csauer42/rover/avr/notes.txt

AVR Motor Control

Receives 11-byte control message for motor positions:

[FF]    [XX]   [XX]   [XX]   [XX]   [XX]   [XX]  [XX]  [XX]   [XX]   [XX] 
start   motor  motor  motor  motor  servo pan    servo tilt   <--crc_16-->
byte    left   right  left   right
        fw     fw     bw     bw

Responds with 10-bit ADC value in 2-byte message.

Fuse Settings:
0xE2 0xD9 0xFF

From default, uncheck 'Divide clock by 8 internally.'

Written for Atmel ATMega328P using Atmel Studio 7.  Pin selection
matches MotorControl schematic.
