csauer42/rover/schematics/rover-board.png

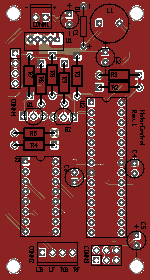
schematics/rover-board.png
