csauer42/rover/schematics/rover-pcb.pdf

# /home/csauer/Projects/rover/schematics/rover.pcb

# 1. Table of Contents (This Page) Created on Thu May 18 17:42:11 2017

# 2. top 3. bottom 4. outline 5. plated-drill 6. componentmask 7. soldermask 8. topsilk 9. bottomsilk 10. topassembly 11. bottomassembly 12. fab

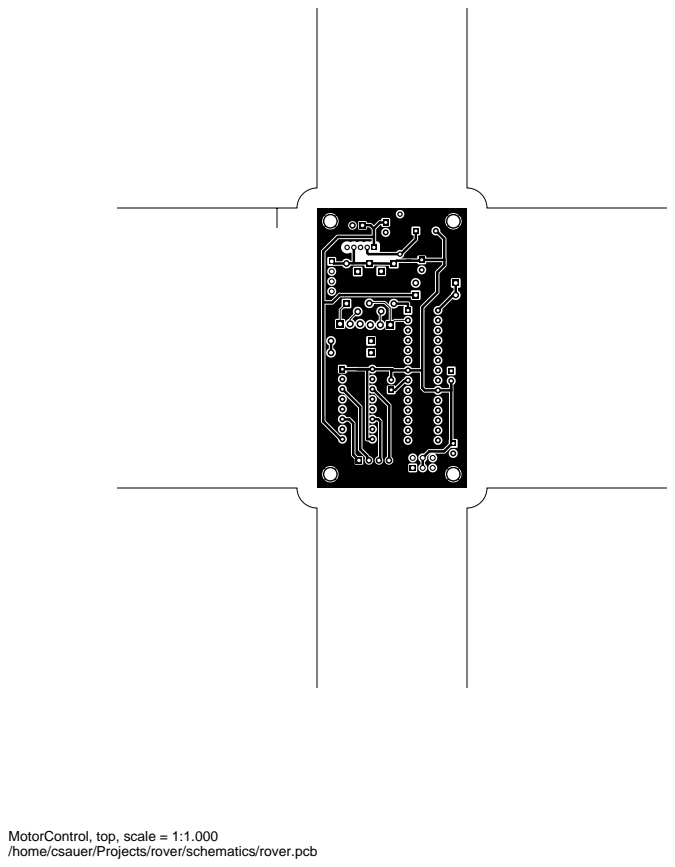
[picture p2: page 2]

MotorControl, top, scale = 1:1.000

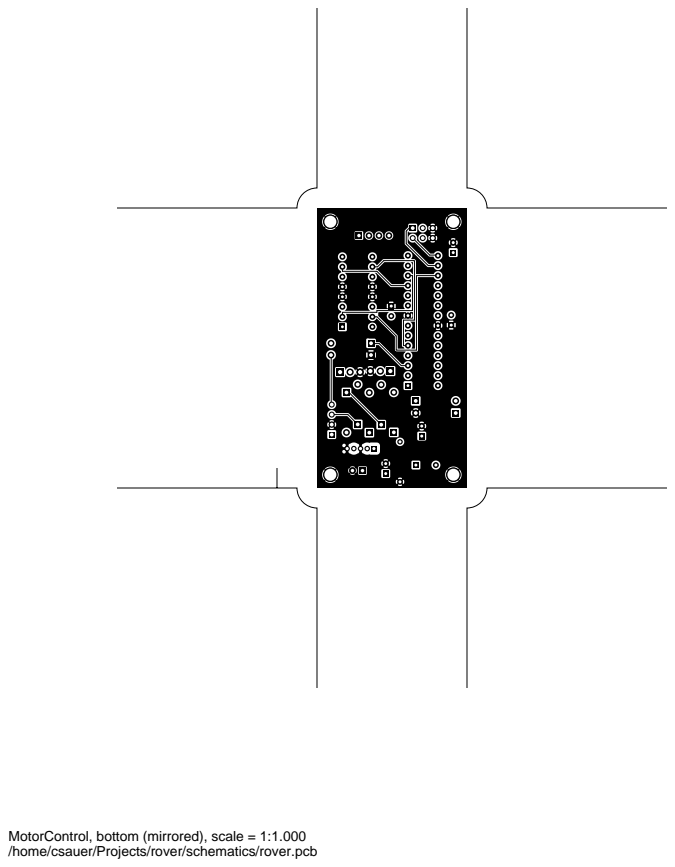
[picture p3: page 3]

MotorControl, bottom (mirrored), scale = 1:1.000

MotorControl, outline, scale = 1:1.000

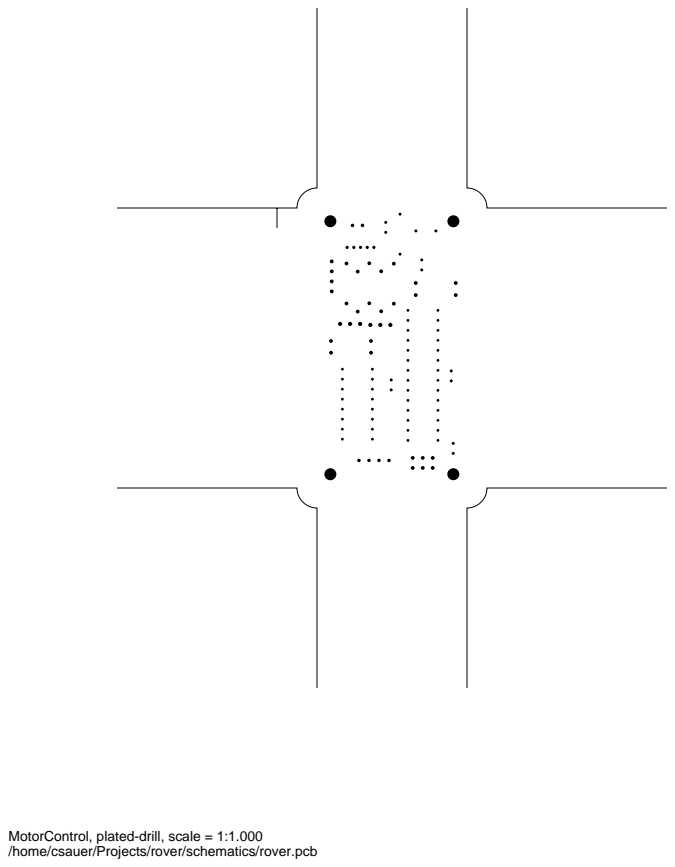
[picture p4: page 5]

MotorControl, plated-drill, scale = 1:1.000

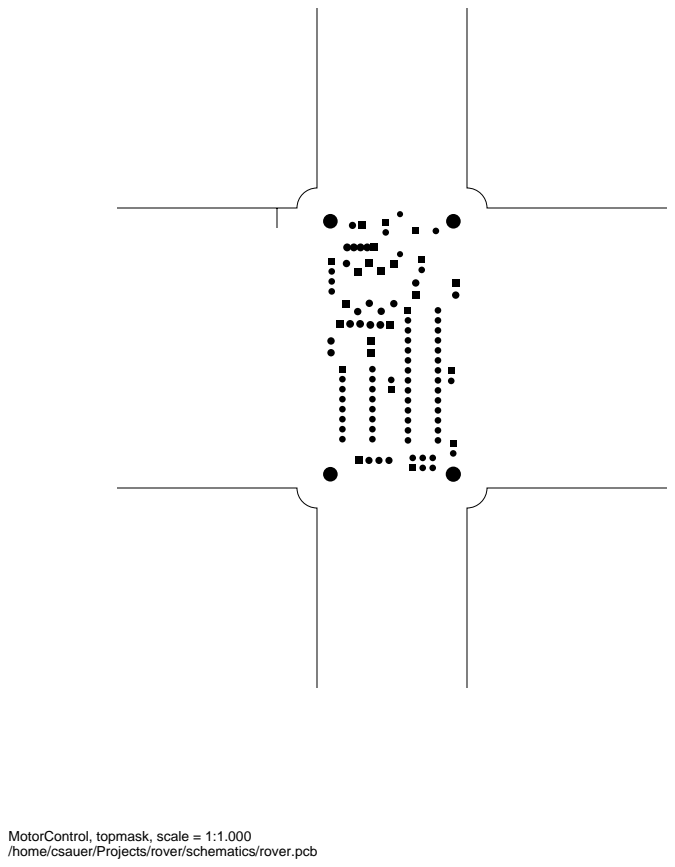
[picture p5: page 6]

MotorControl, topmask, scale = 1:1.000

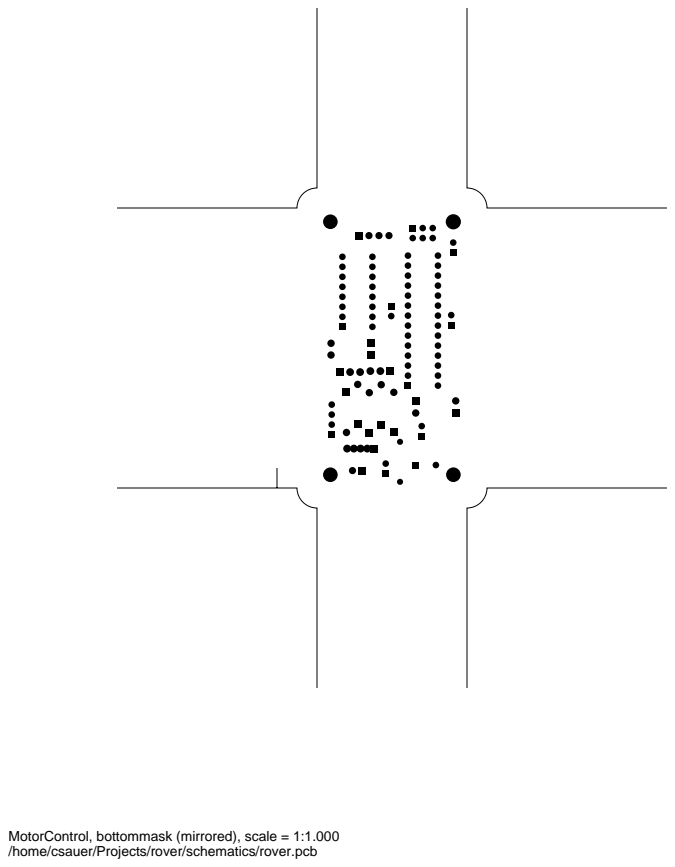
[picture p6: page 7]

MotorControl, bottommask (mirrored), scale = 1:1.000

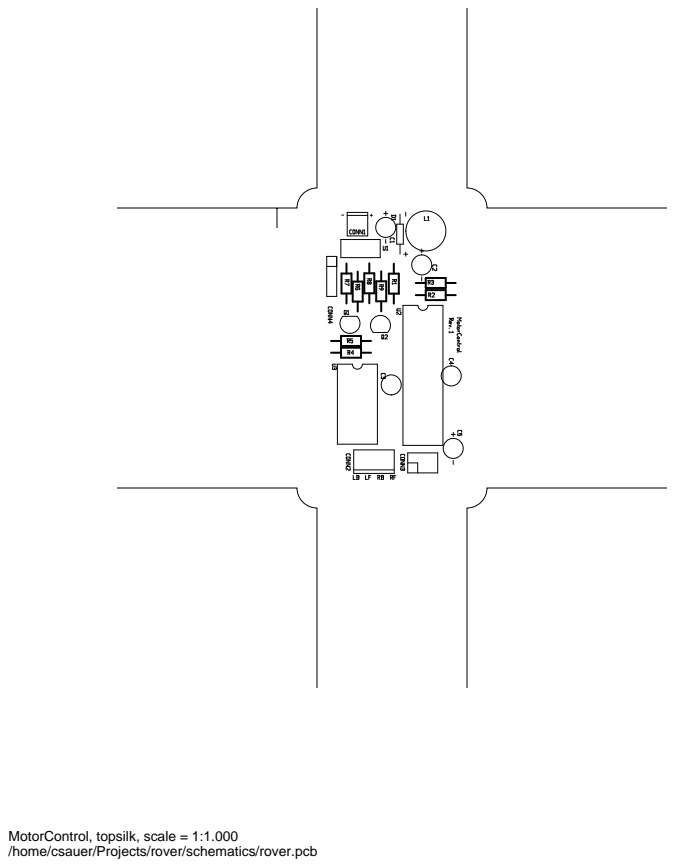
[picture p7: page 8]

MotorControl, topsilk, scale = 1:1.000

MotorControl, bottomsilk (mirrored), scale = 1:1.000

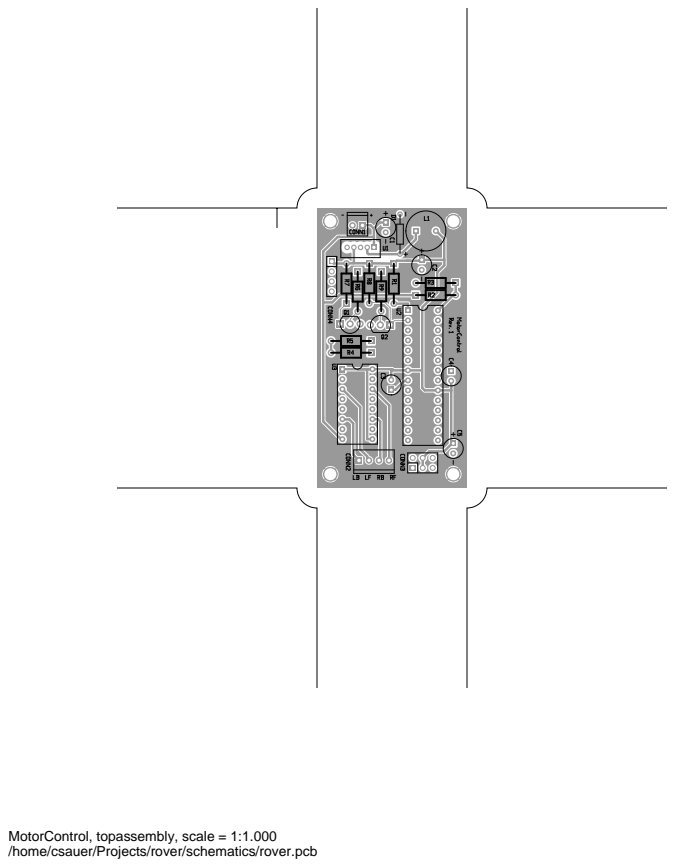
[picture p8: page 10]

MotorControl, topassembly, scale = 1:1.000

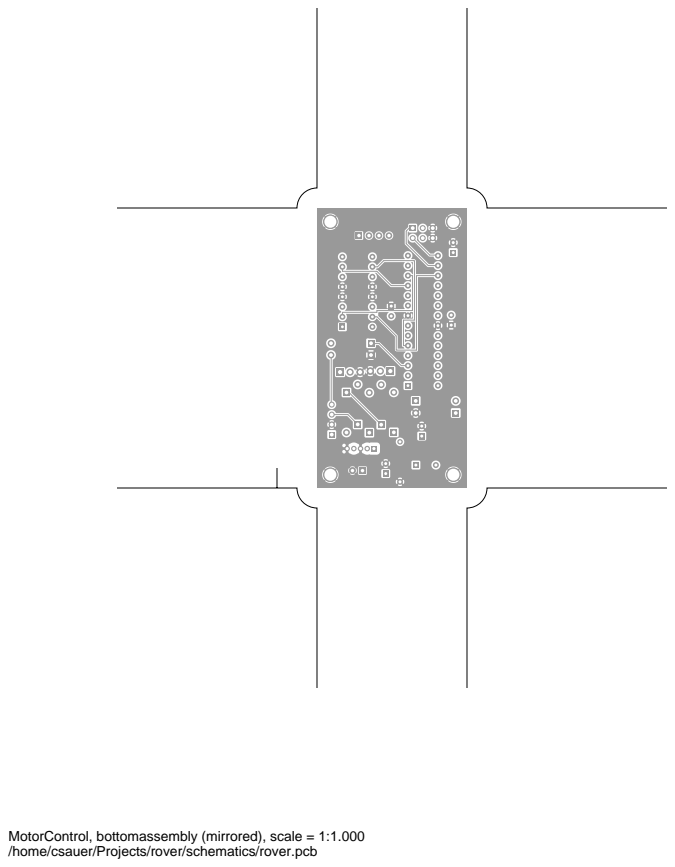
[picture p9: page 11]

MotorControl, bottomassembly (mirrored), scale = 1:1.000

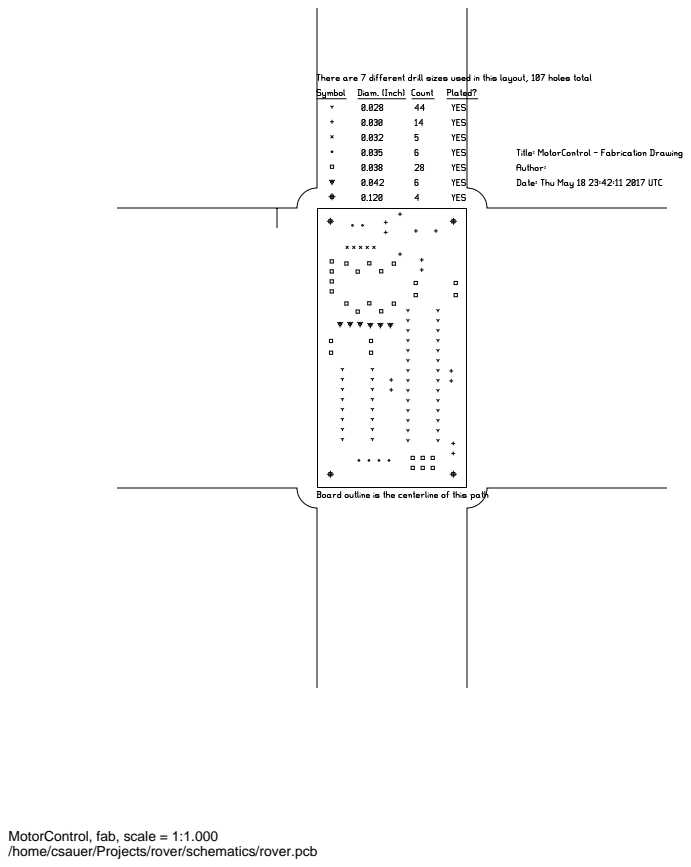
[picture p10: page 12]

MotorControl, fab, scale = 1:1.000
