csauer42/rover/schematics/rover.pdf

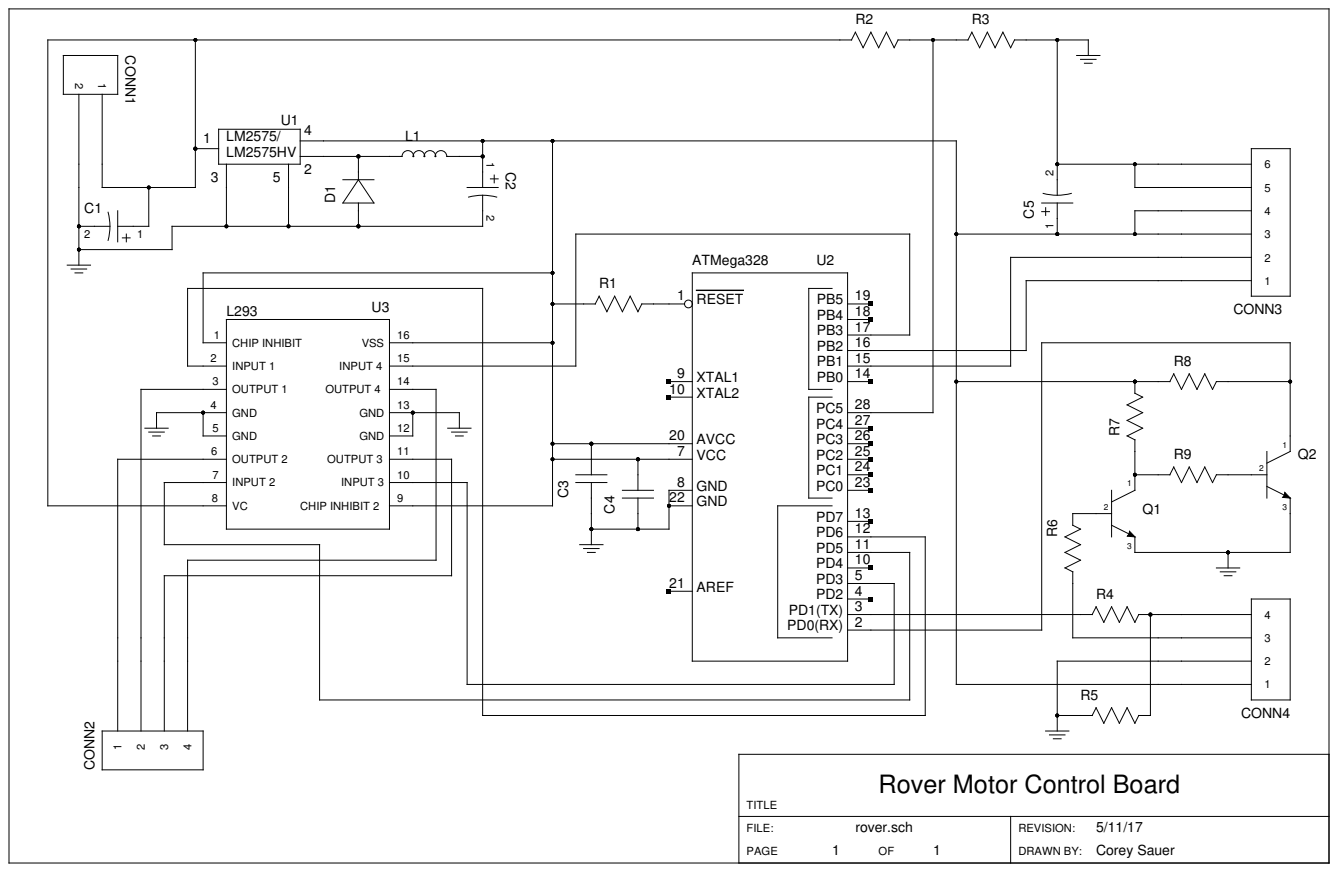
[picture p11: page 1]

Rover Motor Control Board
