csauer42/rover/(list of files, drawings)

Other design files:
schematics/rover.pcb
