csauer42/rover/rpi/include/constants.h

#ifndef CONSTANTS_H
#define CONSTANTS_H

#define CLENGTH 11        // length of serial command
#define MAXMOTOR 255.0    // maximum value for dc motor (8-bit)
#define LOOK_OFFSET 511   // offset value for servo motor (10-bit)
#define FILTER_BYTE 0xFF  // start byte for serial read, do not send in command

#endif
