csauer42/rover/(commit log)

2017-01-14 added atmel studio uart/pwm project to repo
2017-01-15 serial setup fixes, additional tests, evdev replaces pygame
    [SerialAutoTest.cpp, serial_setup.cpp, serial_setup.h]
2017-01-22 python code for gamepad->socket
2017-01-23 Moved working AVR code into MotorControlV1, added ADC read
    [MotorControlV1.componentinfo.xml]
2017-05-07 first draft of schematic for mc board
    [rover.sch]
2017-05-07 schematic cleanup and corrections, added title block info
    [rover.sch]
2017-05-07 updated README, added postscript version of schematic
2017-05-07 schematic cleanup
    [rover.sch]
2017-05-07 embedded custom parts into schematic
    [rover.sch]
2017-05-08 schematic updates, added pdf version, initial pass as pcb layout
    [rover-initial-layout.pcb, rover.pcb, rover.sch]
2017-05-10 adjusted footprints, played with board layout
    [rover.pcb, rover.sch]
2017-05-10 pcb placement cleanup
    [rover-initial-layout.pcb, rover.pcb, rover.sch]
2017-05-11 schematic adjustments, initial pcb layout finished
    [rover.pcb, rover.sch]
2017-05-11 fixed extra mounting holes, removed ps files from repo, added png file
    [rover.pcb]
2017-05-12 board/footprint cleanup
    [rover.pcb, rover.sch]
2017-05-12 Board cleanup, added bom
    [rover.pcb, rover.sch]
2017-05-16 changed terminal blocks, adjusted for manufacturing
    [rover.pcb, rover.sch]
2017-05-18 final (?) changes to MotorControl V1 board
    [rover.pcb]
2017-05-18 really final changes because boards have been ordered
    [rover.pcb]
2017-05-27 Switched to internal uart for rpi in Intermediary.cpp
2017-06-04 switched motor pin output to match board redesign
    [main.c]
2018-02-11 code cleanup, changed target framerate to 15 fps
